signalcompose/mmk_hard/mmk3/mmk3.B.jpg

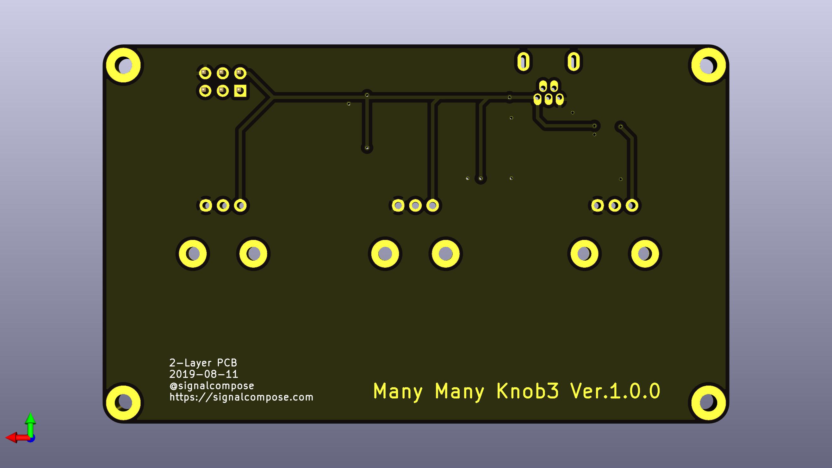
mmk3/mmk3.B.jpg
