signalcompose/mmk_hard/mmk3/mmk3.F.jpg

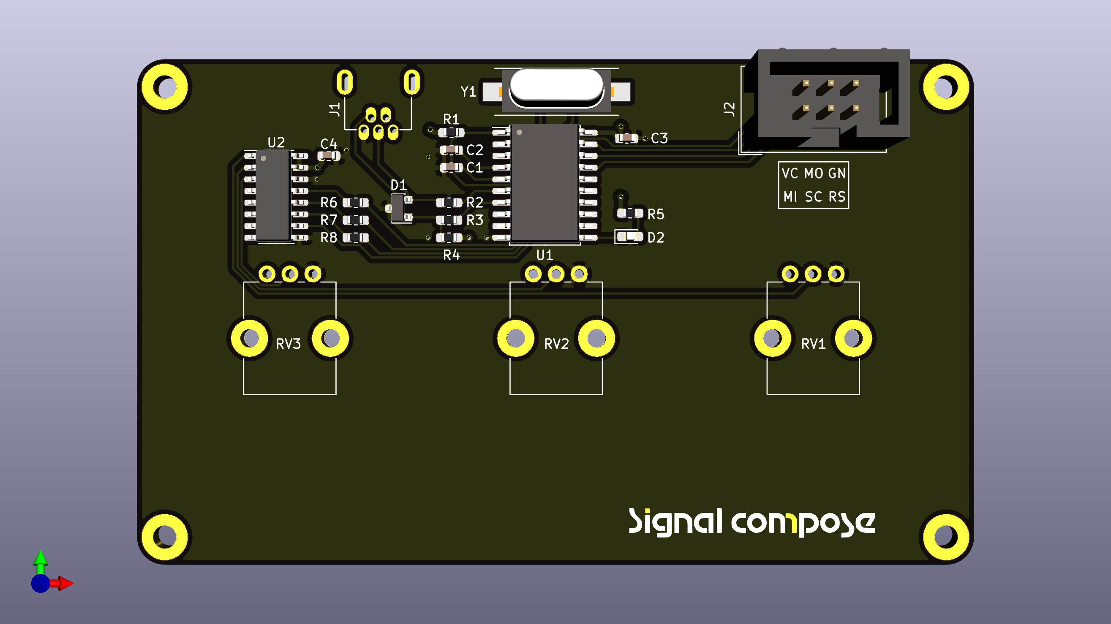
mmk3/mmk3.F.jpg
