signalcompose/mmk_hard/SimpleControl_Hardware.kicad_pcb.pdf

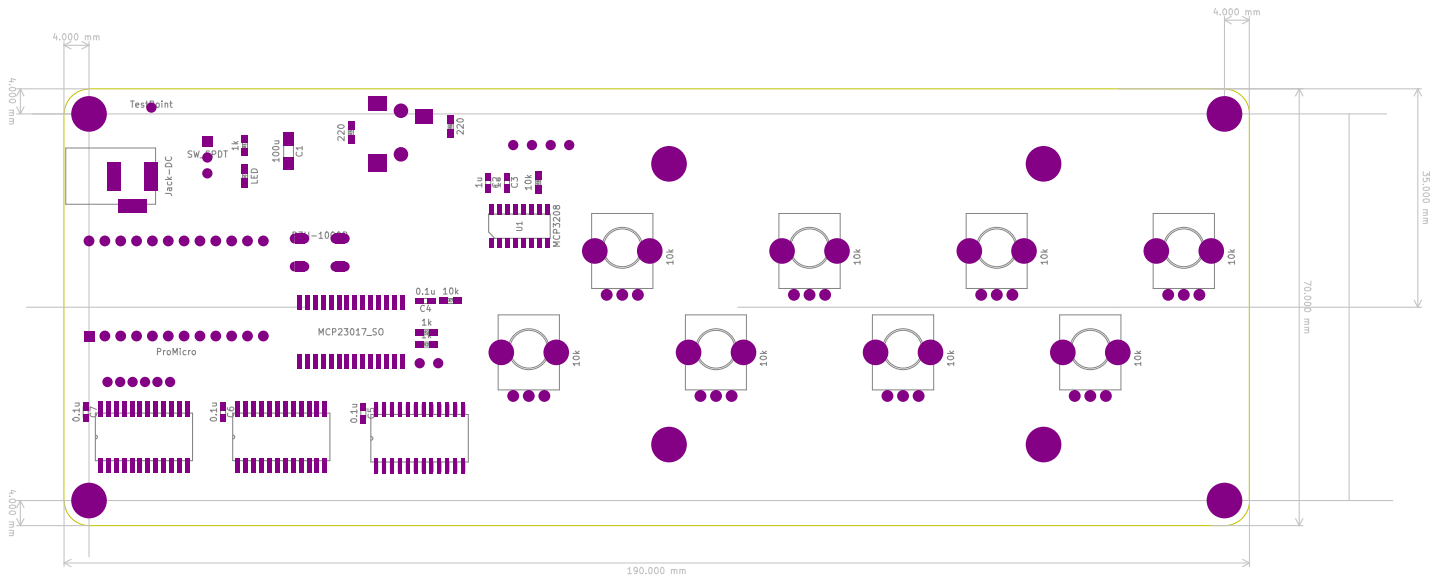
[picture p3: page 1]
