signalcompose/mmk_hard/SimpleControl_Hardware.sch.pdf

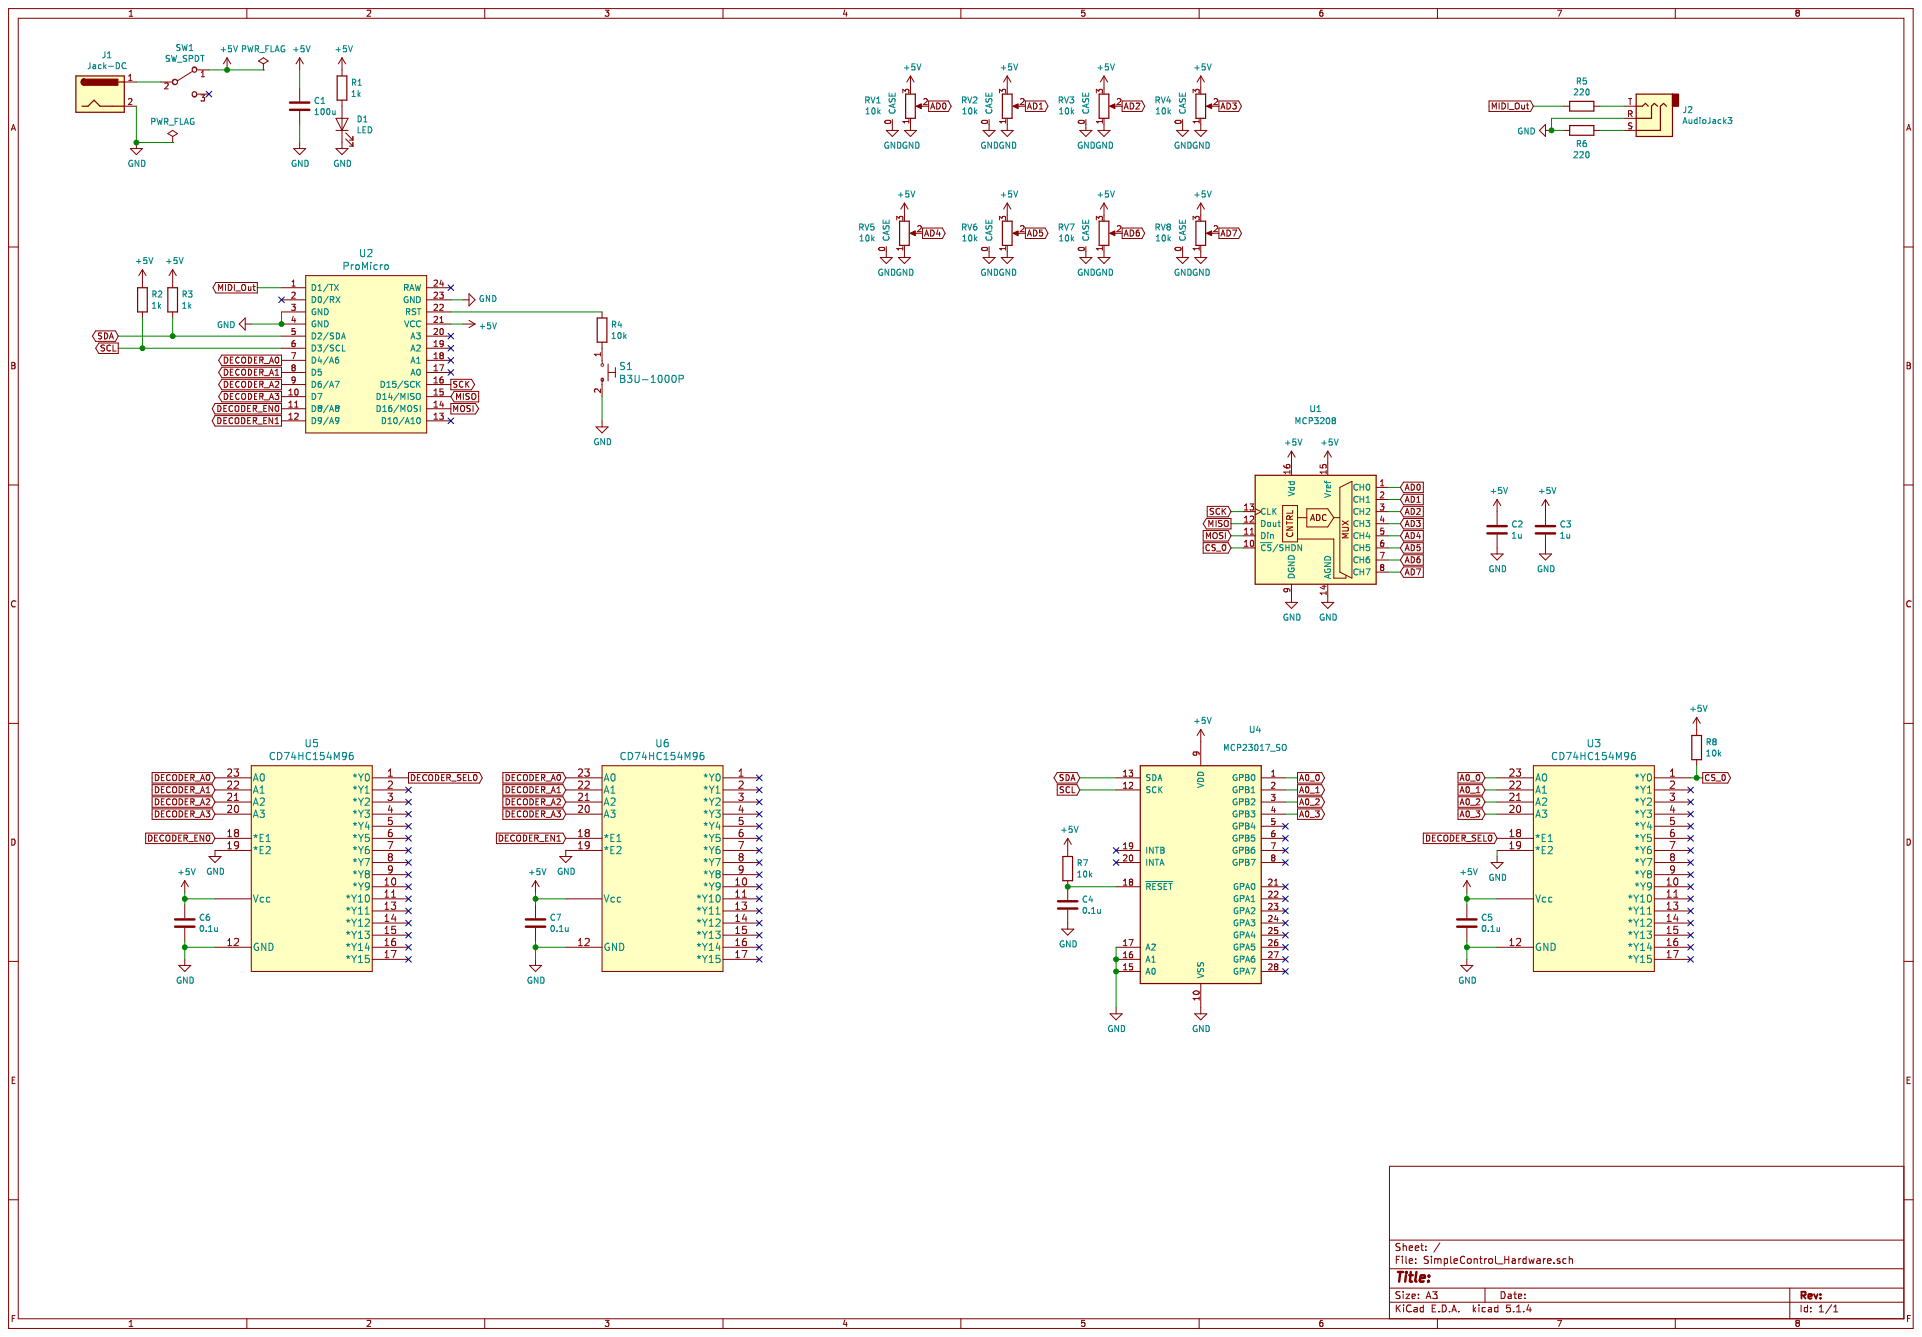
[picture p4: page 1]
