signalcompose/mmk_hard/mmk3/mmk3.kicad_pcb

## KiCad design mmk3/mmk3.kicad_pcb (2019-12-05)

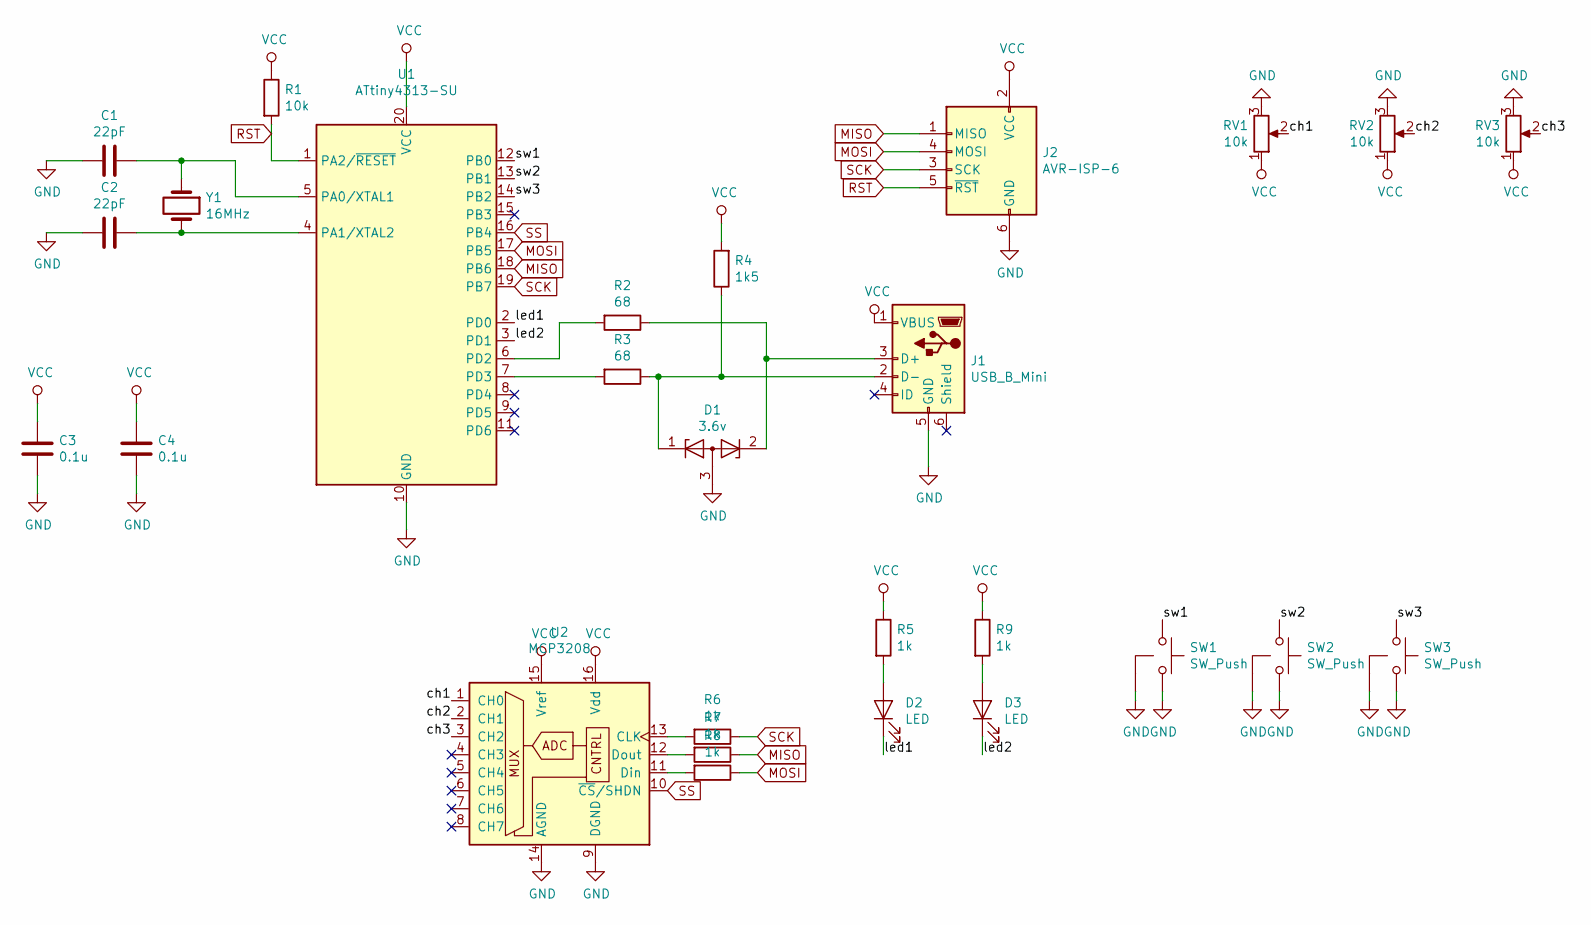
[picture p7: schematic mmk3.sch]

Parts:
C1, C2: 22pF; C_0603_1608Metric
C3, C4: 0.1u; C_0603_1608Metric
D1: 3.6v; SOT-23
D2, D3: LED; LED_0603_1608Metric_Pad1.05x0.95mm_HandSolder
J1: USB_B_Mini; USB_Mini-B_Molex
J2: AVR-ISP-6; IDC-Header_2x03_P2.54mm_Vertical
R1: 10k; R_0603_1608Metric_Pad1.05x0.95mm_HandSolder
R2, R3: 68; R_0603_1608Metric_Pad1.05x0.95mm_HandSolder
R4: 1k5; R_0603_1608Metric_Pad1.05x0.95mm_HandSolder
R5, R6, R7, R8, R9: 1k; R_0603_1608Metric_Pad1.05x0.95mm_HandSolder
RV1, RV2, RV3: 10k; Potentiometer_Alps_RK09K_Single_Vertical
SW1, SW2, SW3: SW_Push; SW_SPST_SKHM
U1: ATtiny4313-SU; SOIC-20W_7.5x12.8mm_P1.27mm
U2: MCP3208; SOIC-16_3.9x9.9mm_P1.27mm
Y1: 16MHz; Crystal_SMD_HC49-SD_2

Connections:
/ch1: RV1.2, U2.1 (CH0)
/ch2: RV2.2, U2.2 (CH1)
/ch3: RV3.2, U2.3 (CH2)
/led1: D2.1 (K), U1.2 (PD0)
/led2: D3.1 (K), U1.3 (PD1)
/sw1: SW1.1, U1.12 (PB0)
/sw2: SW2.1, U1.13 (PB1)
/sw3: SW3.1, U1.14 (PB2)
GND: C1.2, C2.2, C3.1, C4.1, D1.3 (A), J1.5 (GND), J2.6 (GND), RV1.3, RV2.3, RV3.3, SW1.2, SW1.3 (GND), SW2.2, SW2.3 (GND), SW3.2, SW3.3 (GND), U1.10 (GND), U2.9 (DGND), U2.14 (AGND)
MISO: J2.1 (MISO), R7.1, U1.18 (PB6)
MOSI: J2.4 (MOSI), R8.1, U1.17 (PB5)
unnamed: C1.1, U1.5 (PA0/XTAL1), Y1.1
unnamed: C2.1, U1.4 (PA1/XTAL2), Y1.2
unnamed: D1.1 (K), J1.2 (D-), R3.1, R4.1
unnamed: D1.2 (K), J1.3 (D+), R2.1
unnamed: D2.2 (A), R5.2
unnamed: D3.2 (A), R9.2
unnamed: R2.2, U1.6 (PD2)
unnamed: R3.2, U1.7 (PD3)
unnamed: R6.2, U2.13 (CLK)
unnamed: R7.2, U2.12 (Dout)
unnamed: R8.2, U2.11 (Din)
RST: J2.5 (~RST), R1.2, U1.1 (PA2/~RESET)
SCK: J2.3 (SCK), R6.1, U1.19 (PB7)
SS: U1.16 (PB4), U2.10 (~CS~/SHDN)
VCC: C3.2, C4.2, J1.1 (VBUS), J2.2 (VCC), R1.1, R4.2, R5.1, R9.1, RV1.1, RV2.1, RV3.1, U1.20 (VCC), U2.15 (Vref), U2.16 (Vdd)

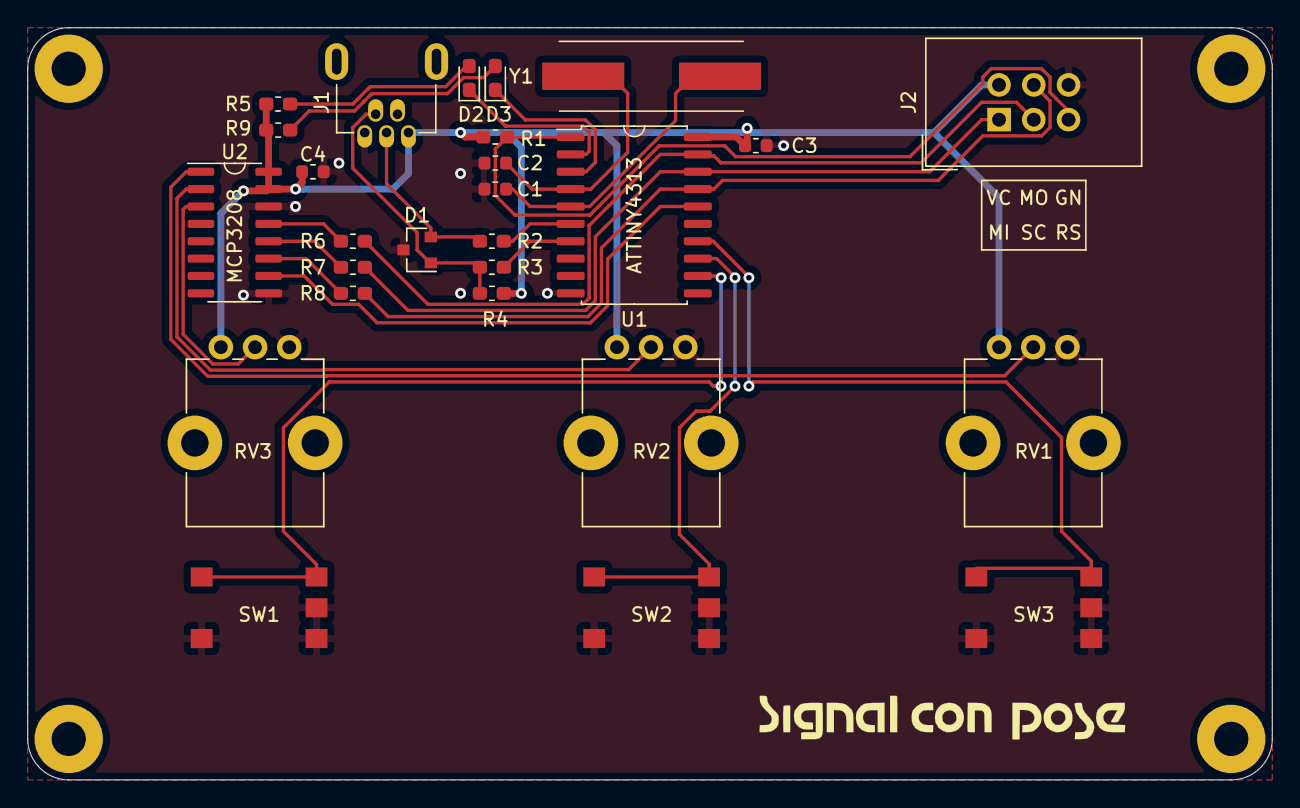
[picture p8: board mmk3.kicad_pcb from above]

Board: 2 copper layers, 91.0 x 55.0 mm, 27 parts (0 on the bottom side), 26 nets.
