signalcompose/mmk_hard/(commit log)

2019-11-29 add schematics
    [SimpleControl_Hardware.kicad_pcb, SimpleControl_Hardware.sch]
2019-12-02 ADCのCSが1つにならない問題を修正しました。
    [SimpleControl_Hardware.sch]
2019-12-02 現状の回路図のpdfも追加しました。
2019-12-04 add footprint info, generate netlist
    [SimpleControl_Hardware.sch]
2019-12-04 correct symbols/footprints
    [SimpleControl_Hardware.kicad_pcb, SimpleControl_Hardware.sch]
2019-12-05 layouting pcb, add initial prototype for reference
    [SimpleControl_Hardware.kicad_pcb, SimpleControl_Hardware.sch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]
2019-12-05 wired. DRC checking OK
    [SimpleControl_Hardware.kicad_pcb]
2019-12-05 add holes, dimensions
    [SimpleControl_Hardware.kicad_pcb]
2019-12-08 add 24 pin connector for extension
    [SimpleControl_Hardware.kicad_pcb, SimpleControl_Hardware.sch]
